DH2LM/AIOC/(commit log)

2024-07-29 Made PCB a little bit more affordable
    Changed USB C Jack from Amphenol 12401832E402A to G-Switch GT-USB-7010ASV
    Changed LDO from MIC5330-SSYML-TR to VRD3333PLX
    [bom.csv, designators.csv, k1-aioc.kicad_pcb, positions.csv]
2024-07-29 Corrected silkscreen on bottom
    [k1-aioc.kicad_pcb]
2024-07-29 Changed designator of Type C Jack in Schematic
    [bom.csv, k1-aioc.kicad_pcb, k1-aioc.kicad_sch]
2024-08-12 Corrected LDO
    [k1-aioc.kicad_pcb]
2024-08-12 Corrected LDO again
    [k1-aioc.kicad_pcb]
2024-09-01 Added Cost reduced version
    [BOM-k1-aioc.csv, bom.csv, designators.csv, k1-aioc.kicad_pcb, k1-aioc.kicad_sch, positions.csv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]
2024-09-05 Made DRC happy regarding errors
    [bom.csv, designators.csv, k1-aioc.kicad_pcb, k1-aioc.kicad_sch, positions.csv]
